Megaomega99/Motorinador/frontend/uploads/noBgColor.png

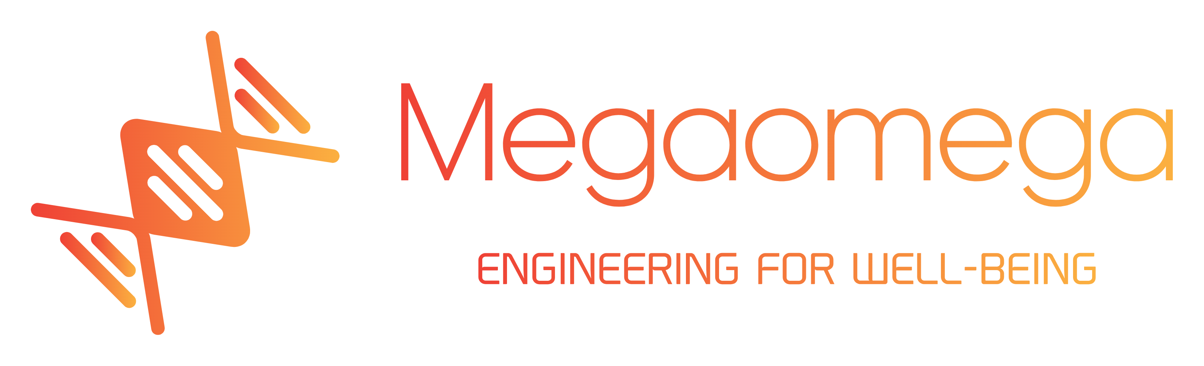
frontend/uploads/noBgColor.png
