Megaomega99/Motorinador/(commit log)

2026-05-11 feat: FastAPI backend + WebSocket frontend integration
    - Backend FastAPI con serial asyncio, WebSocket broadcaster y REST
    - Parser de línea de estado del firmware con regex
    - Traductor de RPM absoluto a secuencia de comandos +/-
    - Reconexión automática del puerto serial con backoff
    - Rate-limiting de comandos RPM (debounce 100 ms)
    - E-STOP sagrado: ignora cola, para inmediatamente
    - Buffer circular de 200 líneas de log para clientes tardíos
    - Persistencia de parámetros en memoria (radius, PPR, microsteps)
    - Frontend index.html conectado al WS real (sin simulación)
    - Tests: parser (20 casos), traductor RPM, protocolo WebSocket
    [config.py, control.py, main.py, models.py, serial_link.py, state.py, ws.py]
2026-05-11 fix: eliminar simulación local y corregir bugs críticos del sistema
    Frontend (index.html):
    - Eliminar ramp/noise simulada de realRPM en el loop de animación
    - Eliminar acumulación local de angleDeg y totalSteps (vienen del backend)
    - El loop de animación solo hace visuals, no modifica state
    - Corregir LEDs: ledPower=serial conectado, ledEnc=encoder activo
    - Sincronizar botones dirSeg cuando backend reporta cambio de dirección
    - No enviar set_target al WS en la carga inicial de la página
    - Clampar targetRPM al rango 5-120 al sincronizar desde backend
    Backend (serial_link.py):
    - cmd_e_stop: para siempre aunque last_status sea None
    - cmd_start/cmd_stop: seguros con last_status=None (pri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
    [main.py, serial_link.py, ws.py]
2026-05-11 feat: servir frontend desde FastAPI — un solo proceso, un solo puerto
    - StaticFiles montado en / al final de app/main.py (rutas API tienen prioridad)
    - WS URL dinámica con window.location.host (funciona en cualquier host)
    - Ahora: python backend/main.py → http://localhost:8000
2026-05-11 chore: reorganize project structure and replace logo
    - Move frontend files to frontend/ subdirectory
    - Update FRONTEND_DIR in backend to point to frontend/
    - Replace placeholder Hámster Labs logo with Megaomega logo (noBgColor.png)
    - Add backend/requirements.txt with pinned dependencies
    - Remove test files, pyproject.toml, and BACKEND.md (no longer needed)
    [main.py]
2026-05-11 docs: add README with setup guide and circuit connections
2026-05-11 Update components list in README
    Removed mention of resistors from the components list.
2026-06-01 Refactor control logic and enhance encoder handling
    - Updated control modes to include free and PI modes with clear command descriptions.
    - Improved velocity measurement using a circular buffer and IIR filter for noise reduction.
    - Enhanced PI control logic with anti-windup conditions and smoother transitions between modes.
    - Added functions to reset and flush velocity buffers to prevent mixing counts from different directions.
    - Improved status reporting to reflect current mode and control values more clearly.
    - Optimized timing for control loop execution and step generation to ensure non-blocking behavior.
    [control.py, main.cpp, models.py, serial_link.py, state.py, ws.py]
2026-07-06 fix: update comment for command actions to include playful tone
    [main.cpp]
2026-07-30 feat: Motorinador v1.0 — control en lazo abierto + análisis de grabaciones
    Versión entregable para investigadores: doble clic y funciona.
    CONTROL DEL MOTOR
    - Tres cosas: activado, velocidad y dirección. Se retiró el controlador PI-IMC
    sobre la velocidad del encoder porque con la transmisión por engranajes era
    incorrecto y peligroso: la consigna significaba dos cosas distintas según el
    modo (el encoder mide 1.98 vueltas por vuelta de motor, no 1) y ante un atasco
    el integrador saturaba y el firmware comandaba RPM_MAX a un motor bloqueado.
    Un stepper con TMC2208 sigue el tren de pasos con exactitud; no hay nada que
    regular. Razonamiento y medidas en docs/superpowers/specs/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
2026-07-30 docs: aclarar el arranque en Linux (PEP 668) y cómo cerrar el programa
    En Windows sigue siendo doble clic en Motorinador.bat. En Linux se usa la
    terminal, que es lo natural para ese público, así que no hay lanzador de
    escritorio.
    - motorinador.sh ya no intenta instalar dependencias: en Ubuntu 23.04+ el Python
    del sistema está marcado como "externally managed" (PEP 668) y `pip install`
    falla siempre, así que solo daba un error confuso. Ahora comprueba las
    dependencias y, si faltan, imprime los comandos exactos (venv + pip, y el
    `sudo apt install python3-venv` por si la creación del entorno falla).
    - README: sección propia para Windows y para Linux/macOS con la instalación en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
2026-08-31 chore: preparar el repo para publicación en GitHub
    Elimina las suites de tests, una nota de investigación interna y la
    configuración local del editor (.vscode, .claude), que no aportan
    información útil a quien vea el proyecto por primera vez. Actualiza
    las referencias rotas en la documentación.
